sistemicorp/a5800-BONDPogo/a5800-CAD_3DwBOND_01.step

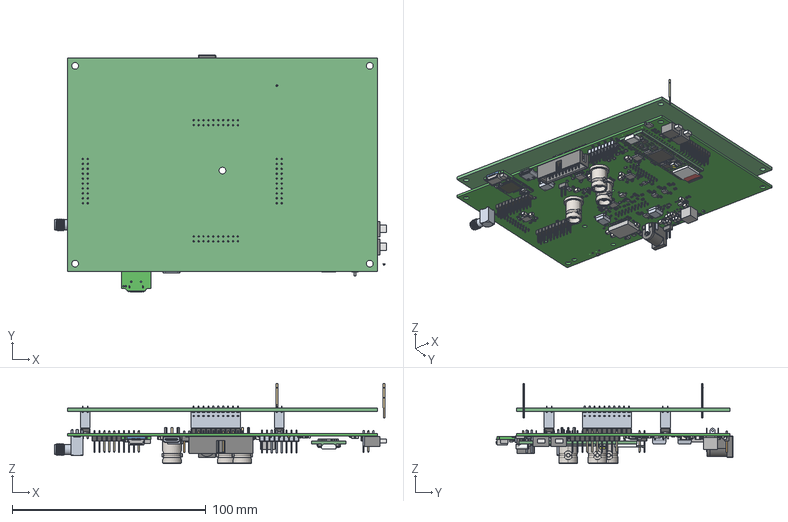
[picture p1: CAD file, 2026-10-26]
a5800-CAD_3DwBOND_01.step
171.2 x 122.2 x 41.4 mm
Extruded x 850
G3VM_61ER x 3
Board
LED0402_greenH05
R0402 x 12
C0402 x 22
C0603 x 8
Open_CASCADE_STEP_translator_6.8_1.31.1.1
Open_CASCADE_STEP_translator_6.8_1.31.1.2
SOT23-5L x 2
LED0402_redH05
R0603
Amphenol_RF_122404 x 3
733910083[1]
TP11CGRA_(1) x 2
pin_header_awl254-dg-g20d x 7
User_Library-SOT23-5-2 x 2
Teensy_4.1_Assembly_simplified
DS-261A_v1
housing x 4
cover x 4
base x 8
Polarity_Mark x 4
Würth_Elektronik_150060YS75000
20_Pin x 21
