sistemicorp/a5800-BONDPogo/a5800-SCH_01.pdf

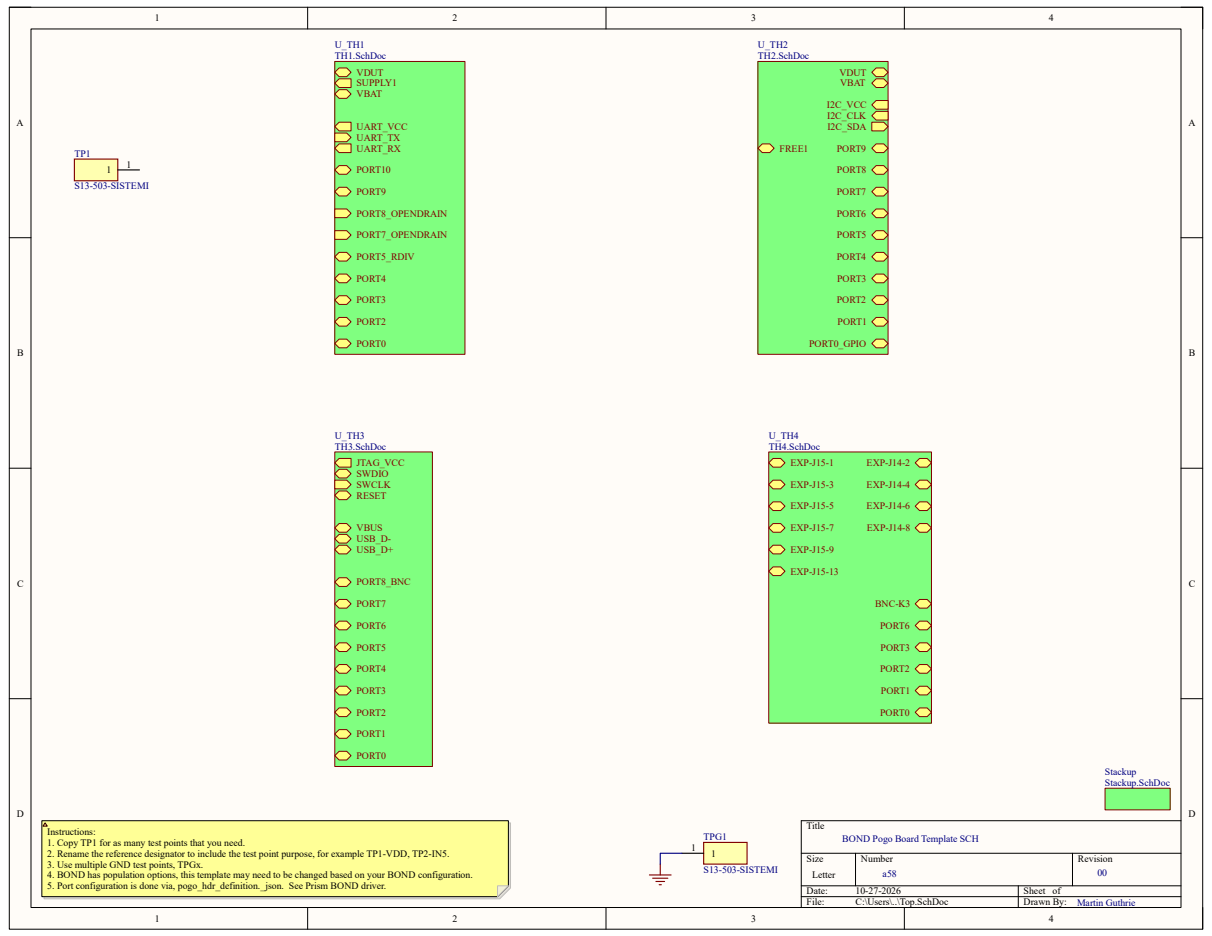
[picture p2: page 1]
Title; Size; Number; Revision; Letter; Date:; Sheet of; File:; C:\Users\..\Top.SchDoc; Drawn By:; Martin Guthrie; UART_VCC; VDUT SUPPLY1 VBAT; UART_TX UART_RX; PORT10; PORT9; PORT8_OPENDRAIN; PORT7_OPENDRAIN; PORT5_RDIV; PORT4; PORT3; PORT2; PORT0; U_TH1 TH1.SchDoc; VDUT VBAT; I2C_CLK; I2C_VCC; I2C_SDA; PORT8; PORT7; PORT6; PORT5; PORT1; PORT0_GPIO; FREE1; U_TH2 TH2.SchDoc; RESET; PORT8_BNC; JTAG_VCC SWDIO SWCLK; USB_D+; USB_D-; VBUS; U_TH3 TH3.SchDoc; EXP-J14-2; EXP-J14-4; EXP-J14-6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

Instructions:
1. Copy TP1 for as many test points that you need.
2. Rename the reference designator to include the test point purpose, for example TP1-VDD, TP2-IN5.
3. Use multiple GND test points, TPGx.
4. BOND has population options, this template may need to be changed based on your BOND configuration.
5. Port configuration is done via, pogo_hdr_definition._json. See Prism BOND driver.

BOND Pogo Board Template SCH

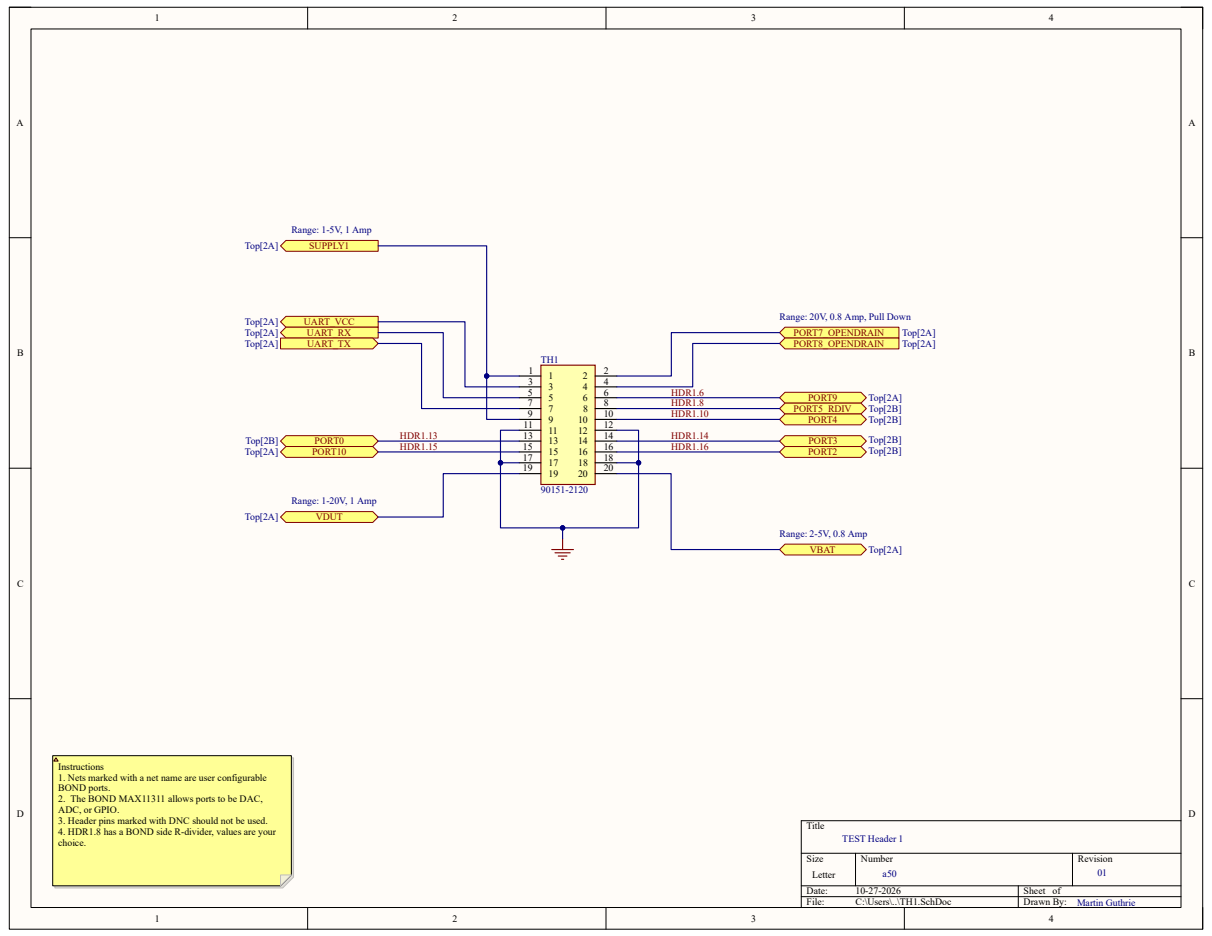
[picture p3: page 2]
Title; File:; C:\Users\..\TH1.SchDoc; Drawn By:; Top[2A]; SUPPLY1; UART_VCC; UART_RX; UART_TX; Top[2B]; PORT0; VDUT; PORT7_OPENDRAIN; PORT8_OPENDRAIN; PORT9; PORT5_RDIV; PORT4; PORT3; PORT2; VBAT; TEST Header 1; HDR1.8; HDR1.6; HDR1.10; HDR1.13; HDR1.14; HDR1.16 Top[2A]; PORT10; HDR1.15; Range: 1-5V, 1 Amp; Range: 1-20V, 1 Amp; Range: 2-5V, 0.8 Amp

Range: 20V, 0.8 Amp, Pull Down

Instructions
1. Nets marked with a net name are user configurable
BOND ports.
2. The BOND MAX11311 allows ports to be DAC,
ADC, or GPIO.
3. Header pins marked with DNC should not be used.
4. HDR1.8 has a BOND side R-divider, values are your
choice.

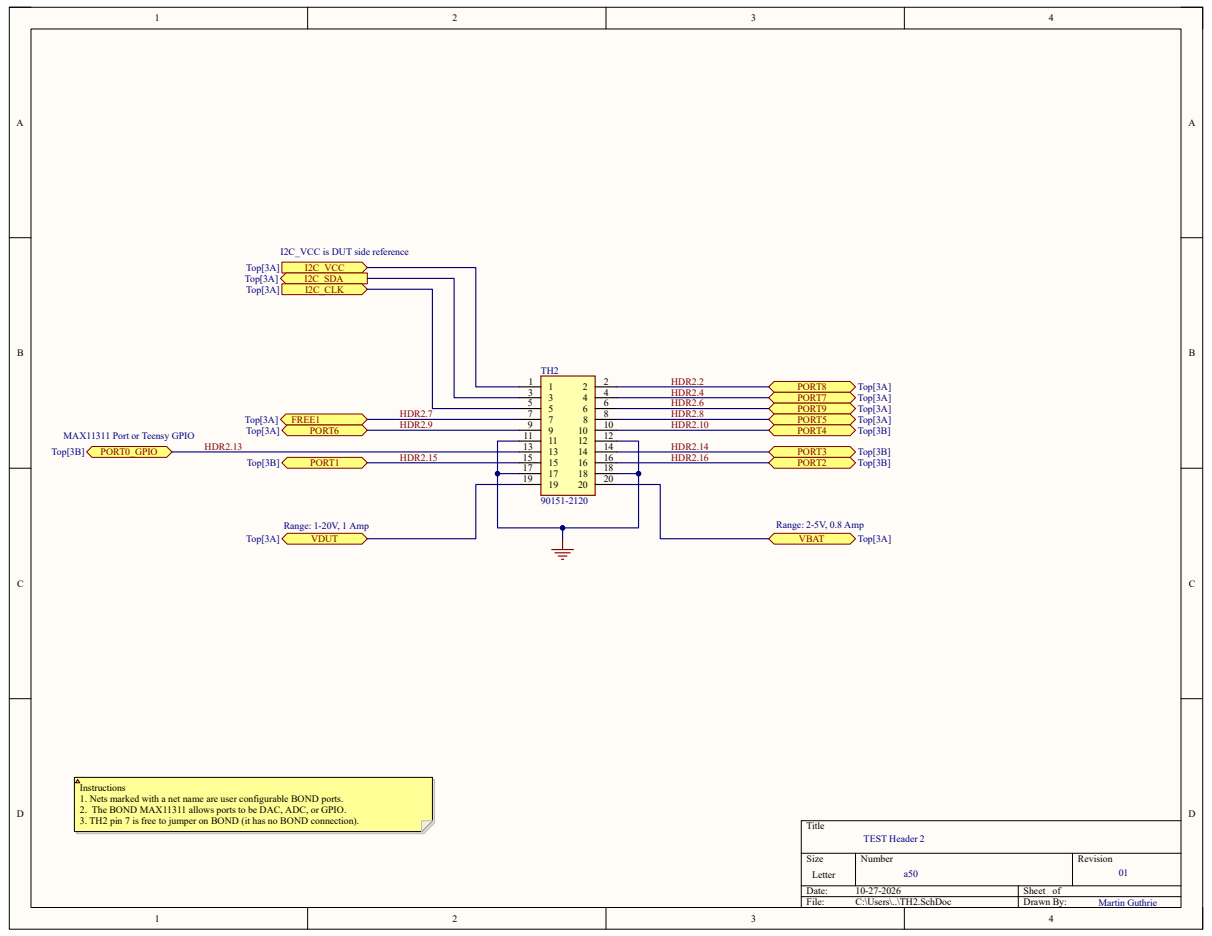
[picture p4: page 3]
Title; File:; C:\Users\..\TH2.SchDoc; Drawn By:; Top[3A]; I2C_VCC; I2C_SDA; I2C_CLK; PORT6; Top[3B]; PORT0_GPIO; PORT1; VDUT; PORT8; PORT7; PORT9; PORT5; PORT4; PORT3; PORT2; VBAT; TEST Header 2; Range: 1-20V, 1 Amp; Range: 2-5V, 0.8 Amp; HDR2.2 HDR2.4 HDR2.6 HDR2.8 HDR2.10; HDR2.14; HDR2.15; HDR2.16; HDR2.13; HDR2.9; Top[3A] FREE1; HDR2.7

I2C_VCC is DUT side reference

MAX11311 Port or Teensy GPIO

Instructions
1. Nets marked with a net name are user configurable BOND ports.
2. The BOND MAX11311 allows ports to be DAC, ADC, or GPIO.
3. TH2 pin 7 is free to jumper on BOND (it has no BOND connection).

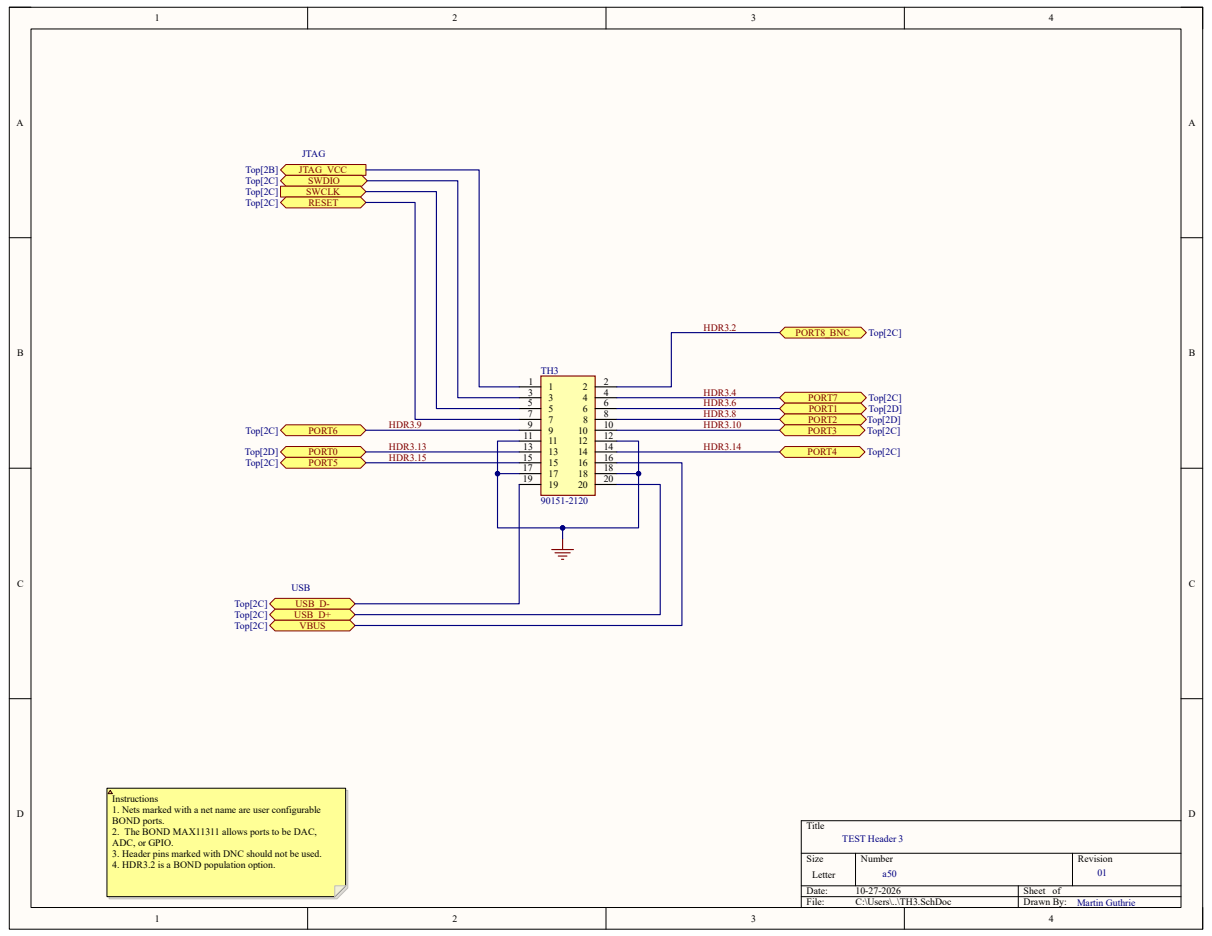
[picture p5: page 4]
Title; File:; C:\Users\..\TH3.SchDoc; Drawn By:; Top[2B]; JTAG_VCC; Top[2C]; SWDIO; SWCLK; RESET; Top[2D]; PORT0; PORT5; USB_D-; PORT8_BNC; PORT7; PORT1; PORT2; PORT3; PORT4; VBUS; USB_D+; TEST Header 3; PORT6; HDR3.4 HDR3.6 HDR3.8 HDR3.10; HDR3.14; HDR3.9; HDR3.13 HDR3.15; JTAG; HDR3.2; USB

Instructions
1. Nets marked with a net name are user configurable
BOND ports.
2. The BOND MAX11311 allows ports to be DAC,
ADC, or GPIO.
3. Header pins marked with DNC should not be used.
4. HDR3.2 is a BOND population option.

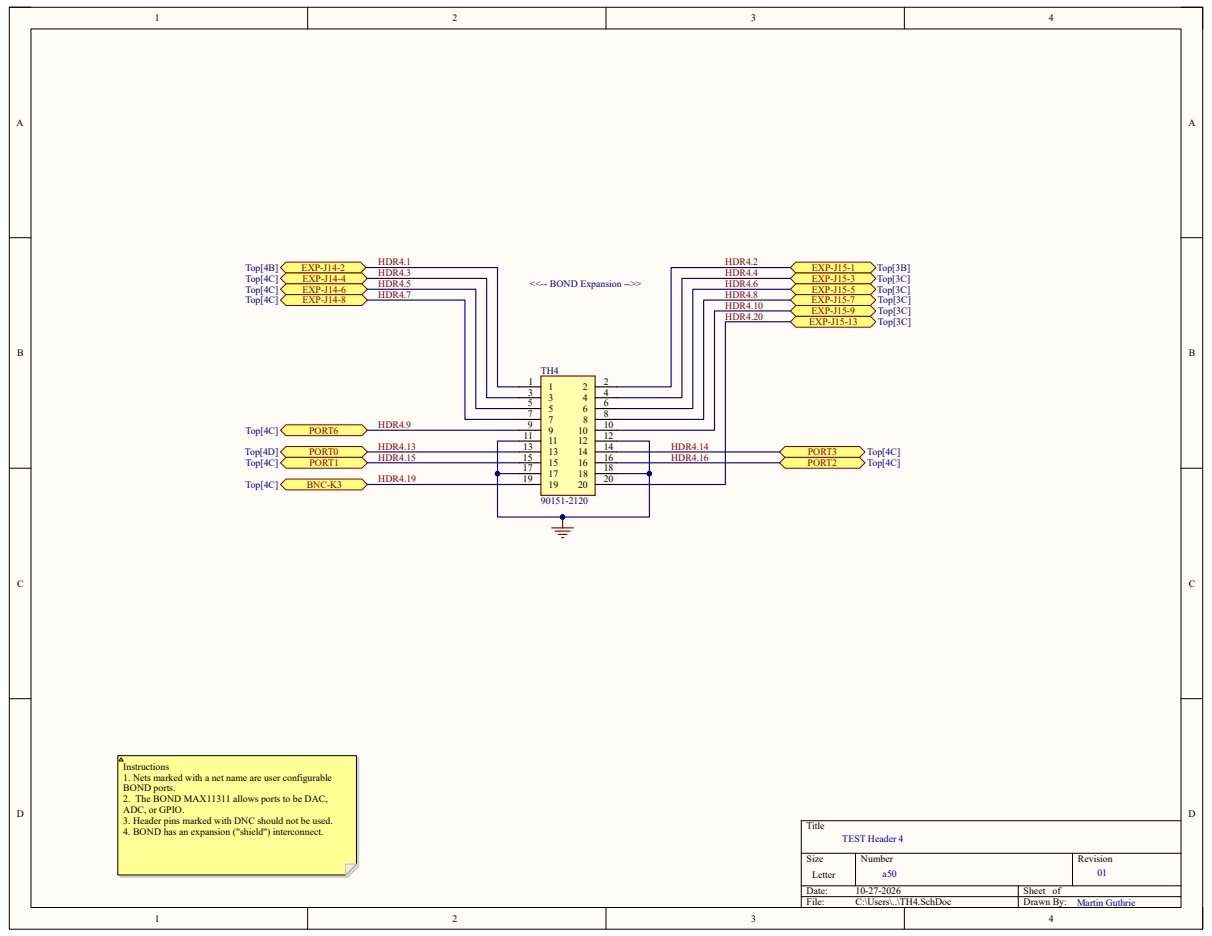
[picture p6: page 5]
Title; File:; C:\Users\..\TH4.SchDoc; Drawn By:; Top[4B]; EXP-J14-2; Top[4C]; EXP-J14-4; EXP-J14-6; EXP-J14-8; Top[4D]; PORT0; PORT1; BNC-K3; EXP-J15-1; Top[3B]; EXP-J15-3; Top[3C]; EXP-J15-5; EXP-J15-7; EXP-J15-9; PORT3; PORT2; EXP-J15-13; TEST Header 4; PORT6; HDR4.1 HDR4.3 HDR4.5 HDR4.7; HDR4.9; HDR4.13 HDR4.15; HDR4.19; HDR4.2 HDR4.4 HDR4.6 HDR4.8 HDR4.10 HDR4.20; HDR4.14 HDR4.16; <<-- BOND Expansion -->>

Instructions
1. Nets marked with a net name are user configurable
BOND ports.
2. The BOND MAX11311 allows ports to be DAC,
ADC, or GPIO.
3. Header pins marked with DNC should not be used.
4. BOND has an expansion ("shield") interconnect.

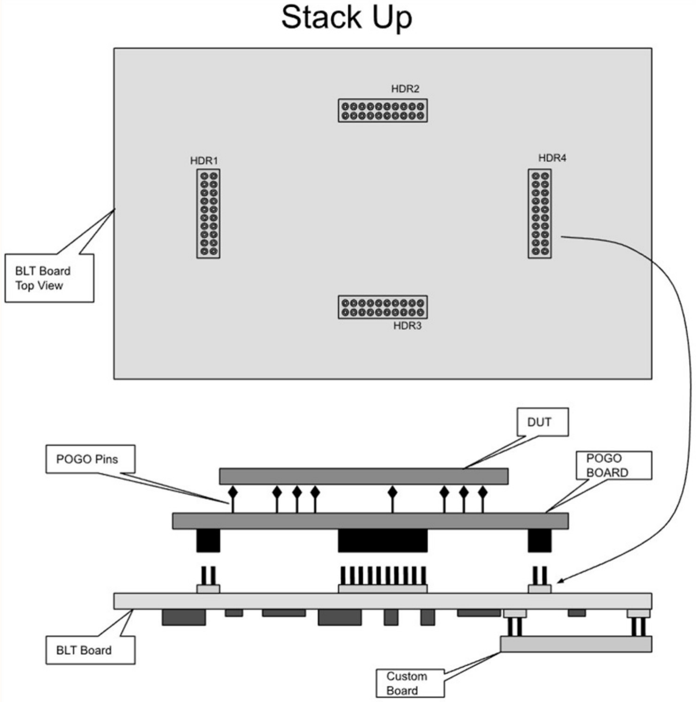
[picture p7: figure]

D D

C C

B B

A A

Title

File: | C:\Users\..\Stackup.SchDoc | Drawn By:
| Stackup Illustration and Notes
a58 | 01

NOTES:

1) The diagram shows the overall stackup of the BLT Board (BOND), the Pogo Board (this Schematic) and the Device Under Test (DUT).
2) The BOND (BLT) board components face away from the Pogo Board. The Headers on BOND face the Pogo Board.
