sistemicorp/a5800-BONDPogo/a4402-SCH_03.pdf

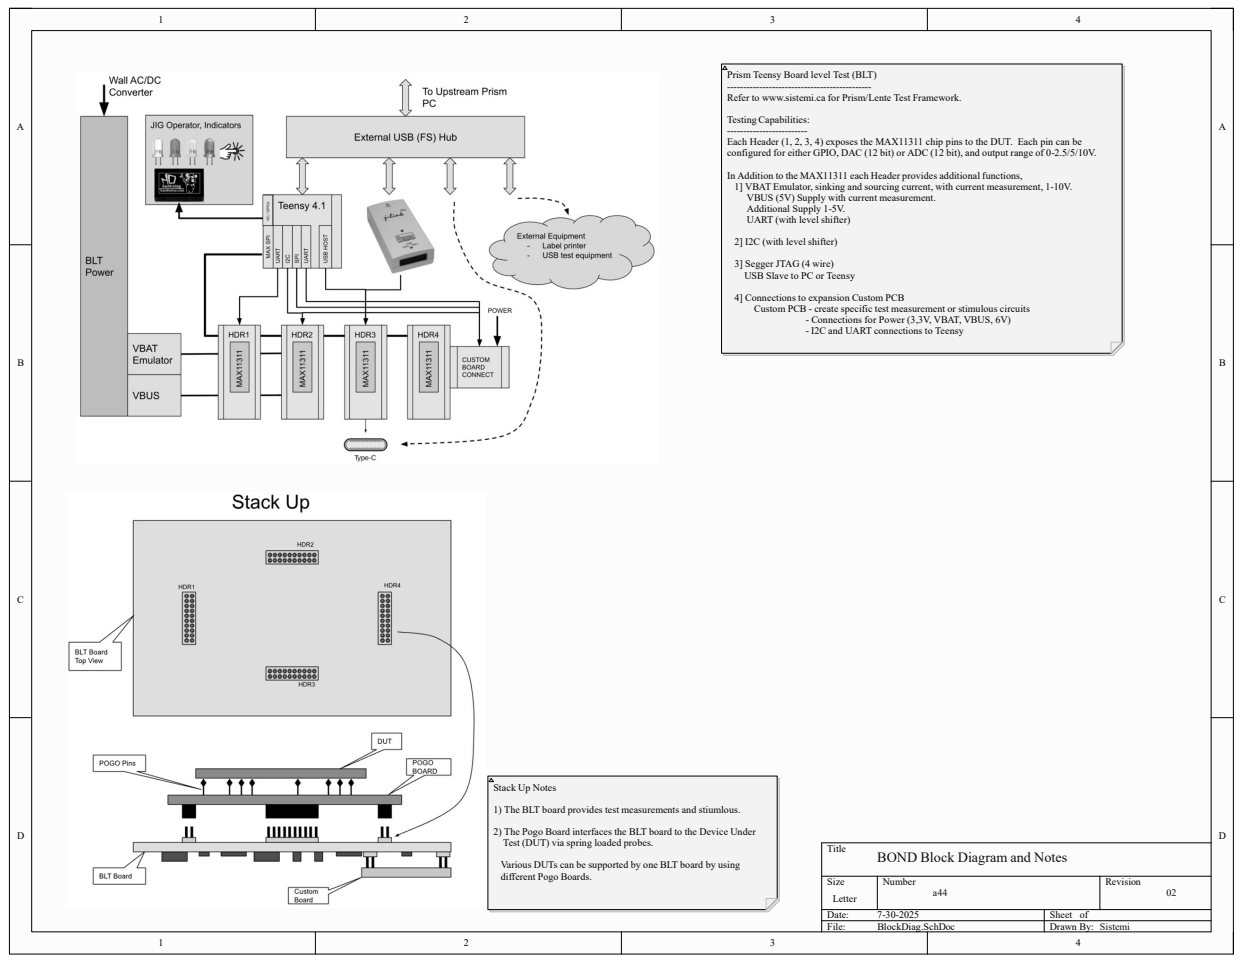
[picture p8: page 1]
Title; Size; Number; Revision; Letter; Date:; Sheet of; File:; BlockDiag.SchDoc; Drawn By: Sistemi

Prism Teensy Board level Test (BLT)
Refer to www.sistemi.ca for Prism/Lente Test Framework.

Testing Capabilities:
Each Header (1, 2, 3, 4) exposes the MAX11311 chip pins to the DUT. Each pin can be
configured for either GPIO, DAC (12 bit) or ADC (12 bit), and output range of 0-2.5/5/10V.

In Addition to the MAX11311 each Header provides additional functions,
1] VBAT Emulator, sinking and sourcing current, with current measurement, 1-10V.
VBUS (5V) Supply with current measurement.
Additional Supply 1-5V.
UART (with level shifter)

2] I2C (with level shifter)

3] Segger JTAG (4 wire)
USB Slave to PC or Teensy

4] Connections to expansion Custom PCB
Custom PCB - create specific test measurement or stimulous circuits

- Connections for Power (3,3V, VBAT, VBUS, 6V)
- I2C and UART connections to Teensy

Stack Up Notes

1) The BLT board provides test measurements and stiumlous.

2) The Pogo Board interfaces the BLT board to the Device Under
Test (DUT) via spring loaded probes.

Various DUTs can be supported by one BLT board by using
different Pogo Boards.

BOND Block Diagram and Notes

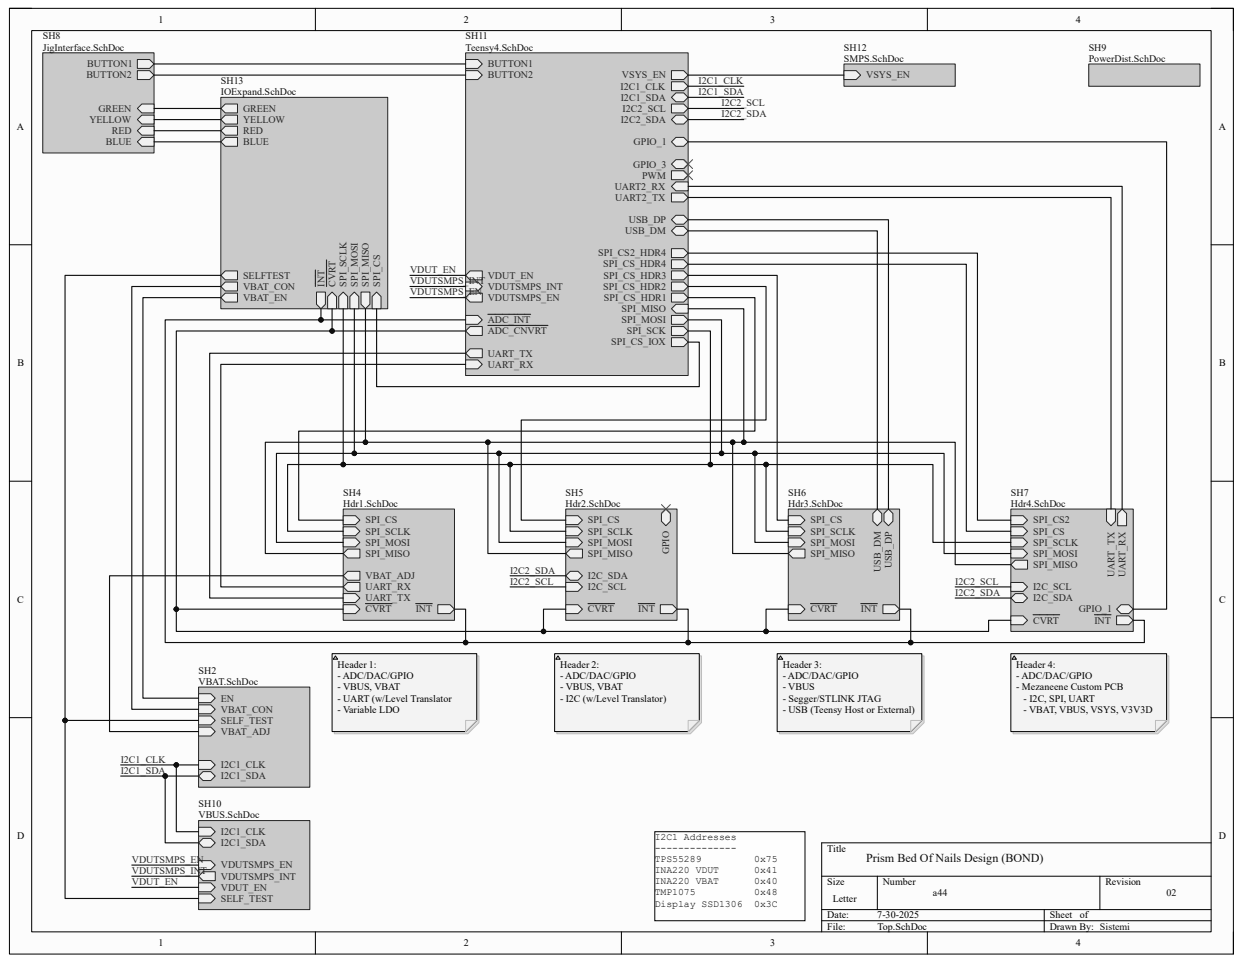
[picture p9: page 2]
File:; Top.SchDoc; Drawn By:; Sistemi; I2C1_SDA; EN VBAT_CON SELF_TEST; I2C1_CLK; VBAT_ADJ; SH2 VBAT.SchDoc; SPI_MOSI; SPI_CS; INT; SPI_MISO; SPI_SCLK; CVRT; UART_TX; UART_RX; SH4 Hdr1.SchDoc; I2C_SDA I2C_SCL; INT GPIO; SH5 Hdr2.SchDoc; INT USB_DM USB_DP; SH6 Hdr3.SchDoc; SPI_CS2; I2C_SDA; SPI_SCLK SPI_MOSI; I2C_SCL; GPIO_1 UART_TX UART_RX; SH7 Hdr4.SchDoc; BLUE; YELLOW RED; BUTTON1; GREEN; BUTTON2; JigInterface.SchDoc; PowerDist.SchDoc; VDUTSMPS_EN VDUTSMPS_INT; SELF_TEST; VDUT_EN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

Header 1:
- ADC/DAC/GPIO
- VBUS, VBAT
- UART (w/Level Translator
- Variable LDO

Header 2:
- I2C (w/Level Translator)

Header 3:
- VBUS
- Segger/STLINK JTAG
- USB (Teensy Host or External)

Header 4:
- Mezaneene Custom PCB
- I2C, SPI, UART
- VBAT, VBUS, VSYS, V3V3D

Title
Prism Bed Of Nails Design (BOND)

## Teensy Powered by VBUS

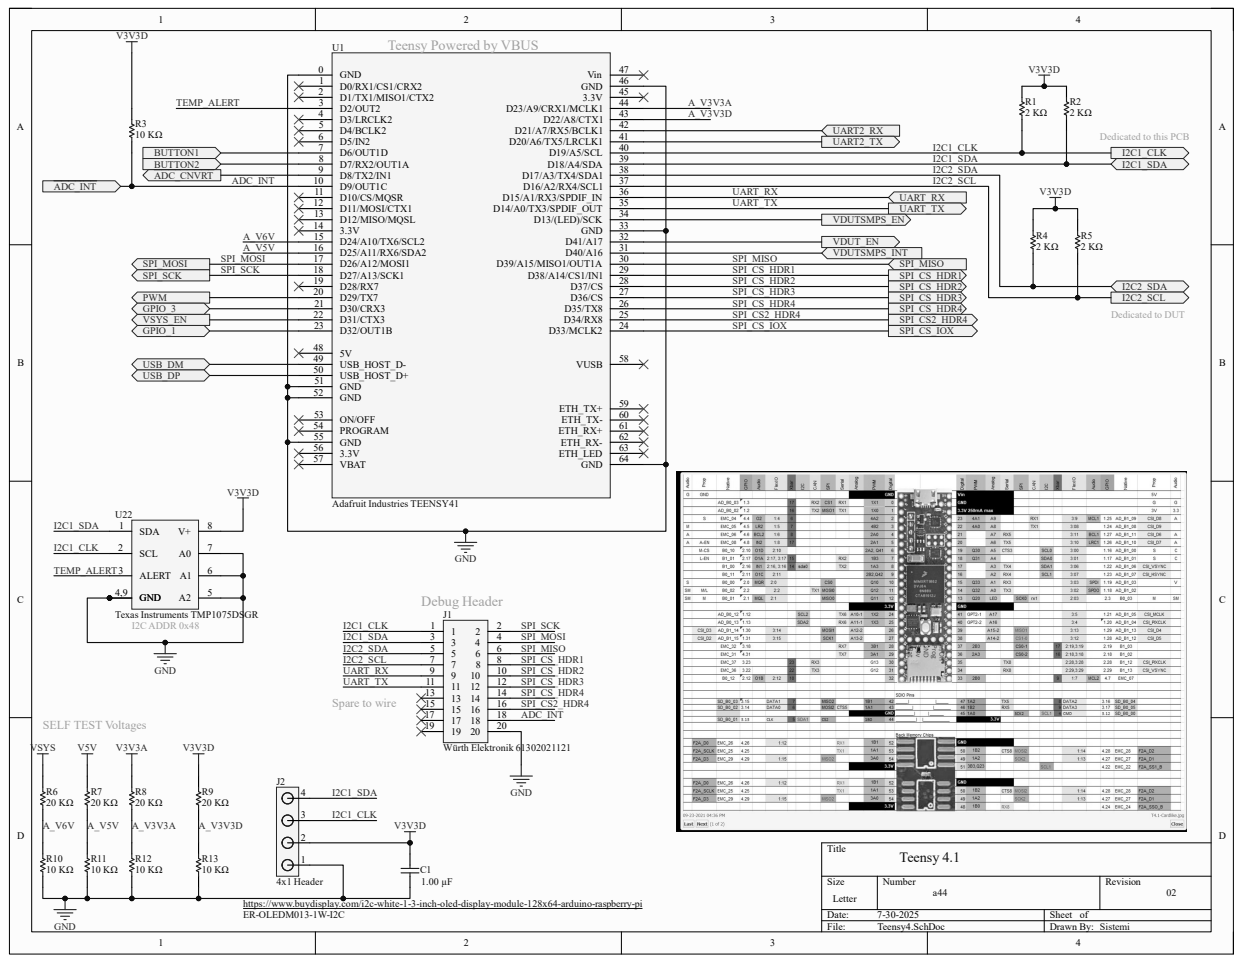
[picture p10: page 3]

Dedicated to this PCB

https://www.buydisplay.com/i2c-white-1-3-inch-oled-display-module-128x64-arduino-raspberry-pi
ER-OLEDM013-1W-I2C

# D1 Würth Elektronik 150060GS⁷⁵⁰⁰⁰

## Reference For ADC Calibration

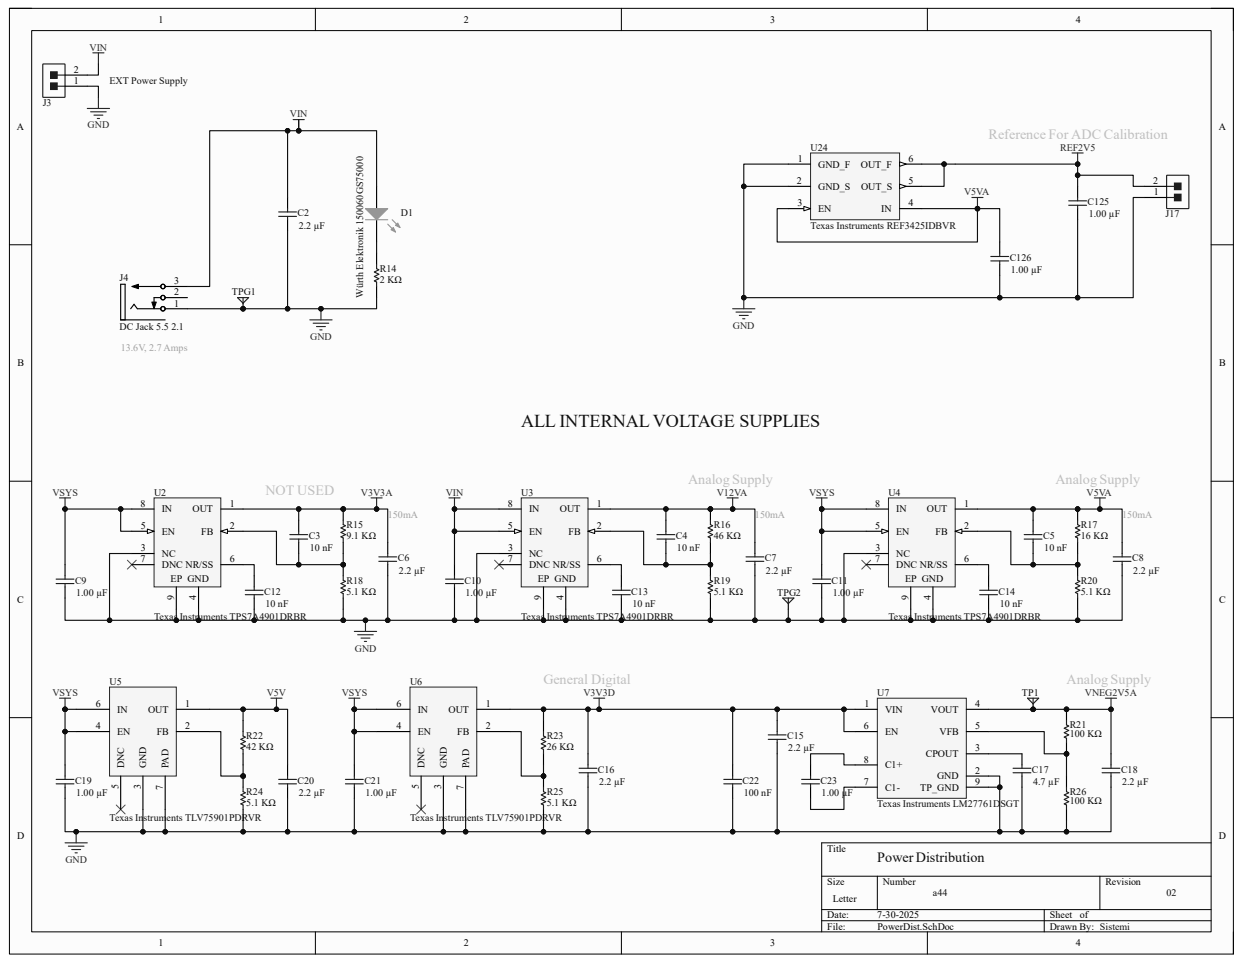
[picture p11: page 4]

ALL INTERNAL VOLTAGE SUPPLIES

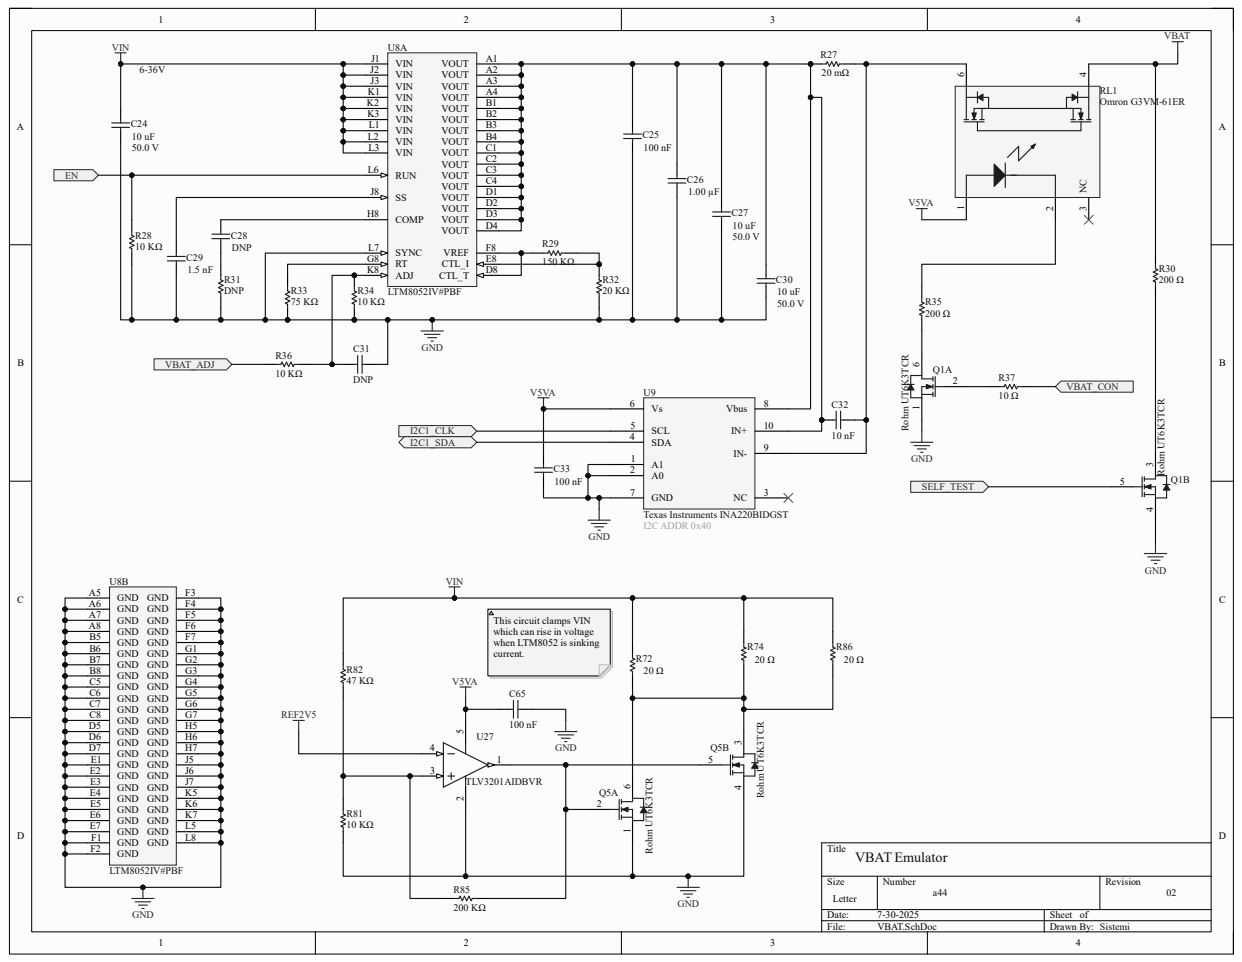
[picture p12: page 5]

This circuit clamps VIN
which can rise in voltage
when LTM8052 is sinking
current.

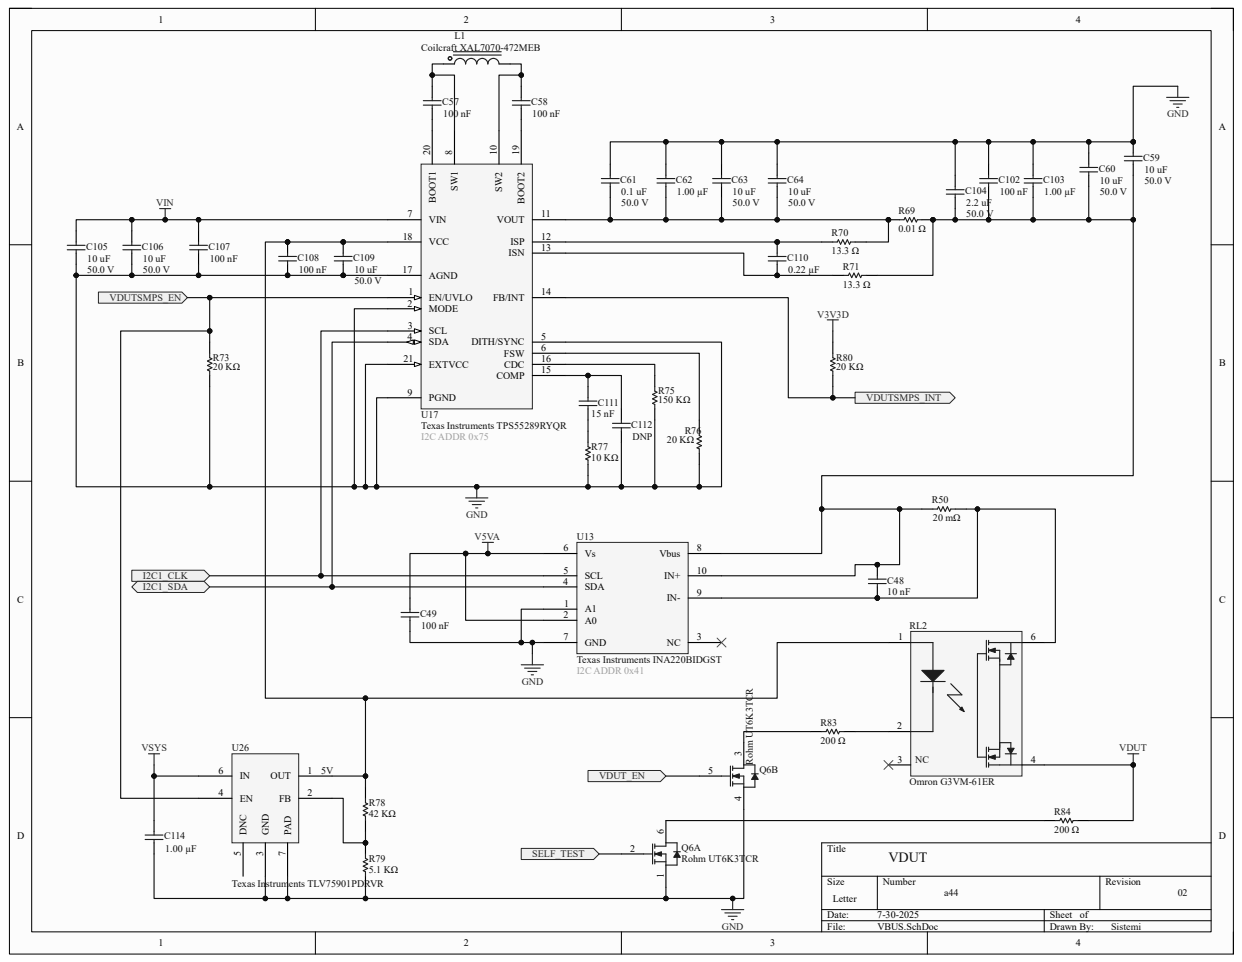
[picture p13: page 6]

## Mounted LEDs/Switches Cable Harness LED Status on-board and off-board, in

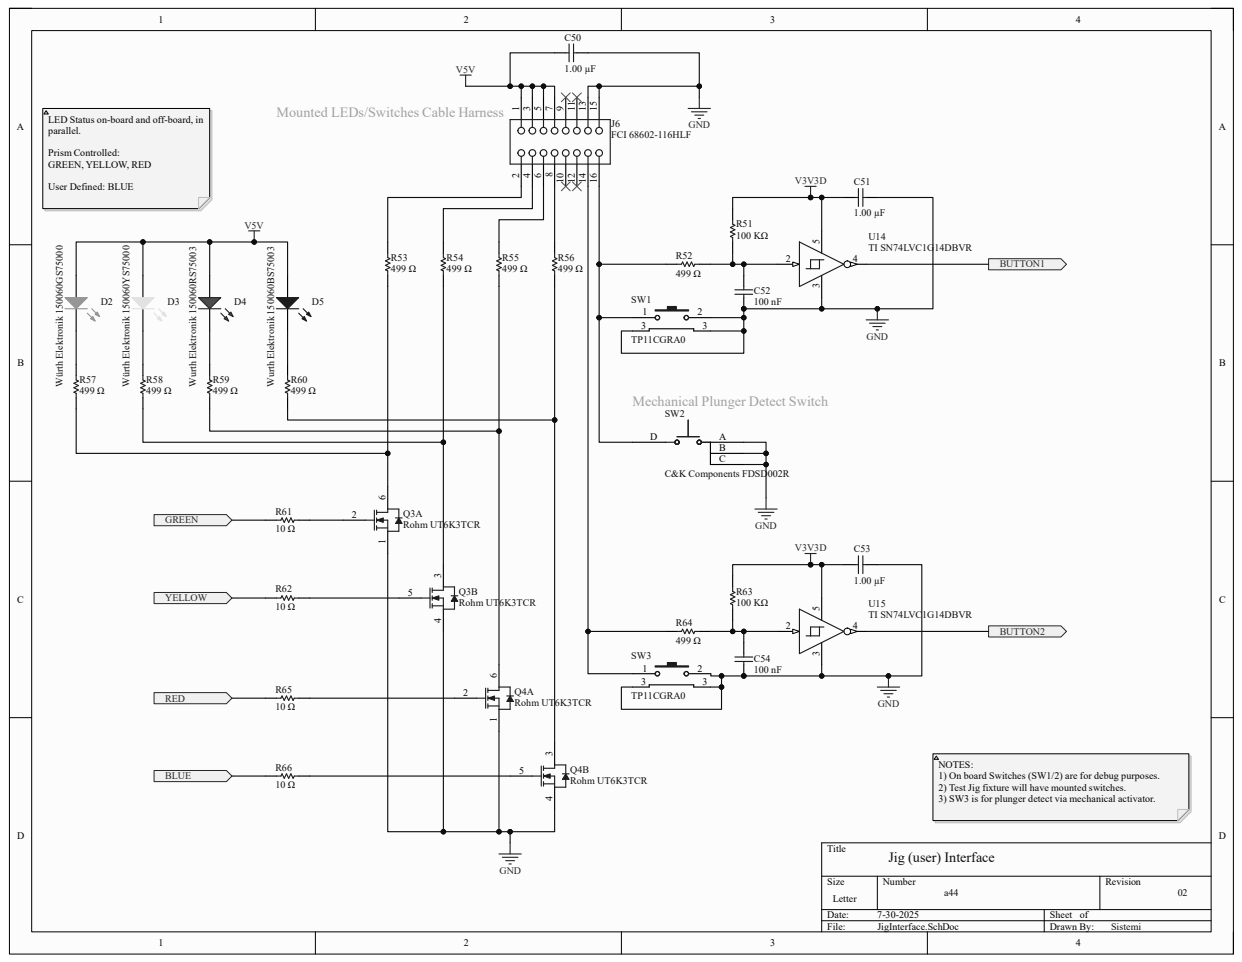
[picture p14: page 7]

Mechanical Plunger Detect Switch

NOTES:
1) On board Switches (SW1/2) are for debug purposes.
2) Test Jig fixture will have mounted switches.
3) SW3 is for plunger detect via mechanical activator.

## DUT Hdr

# GNDUART

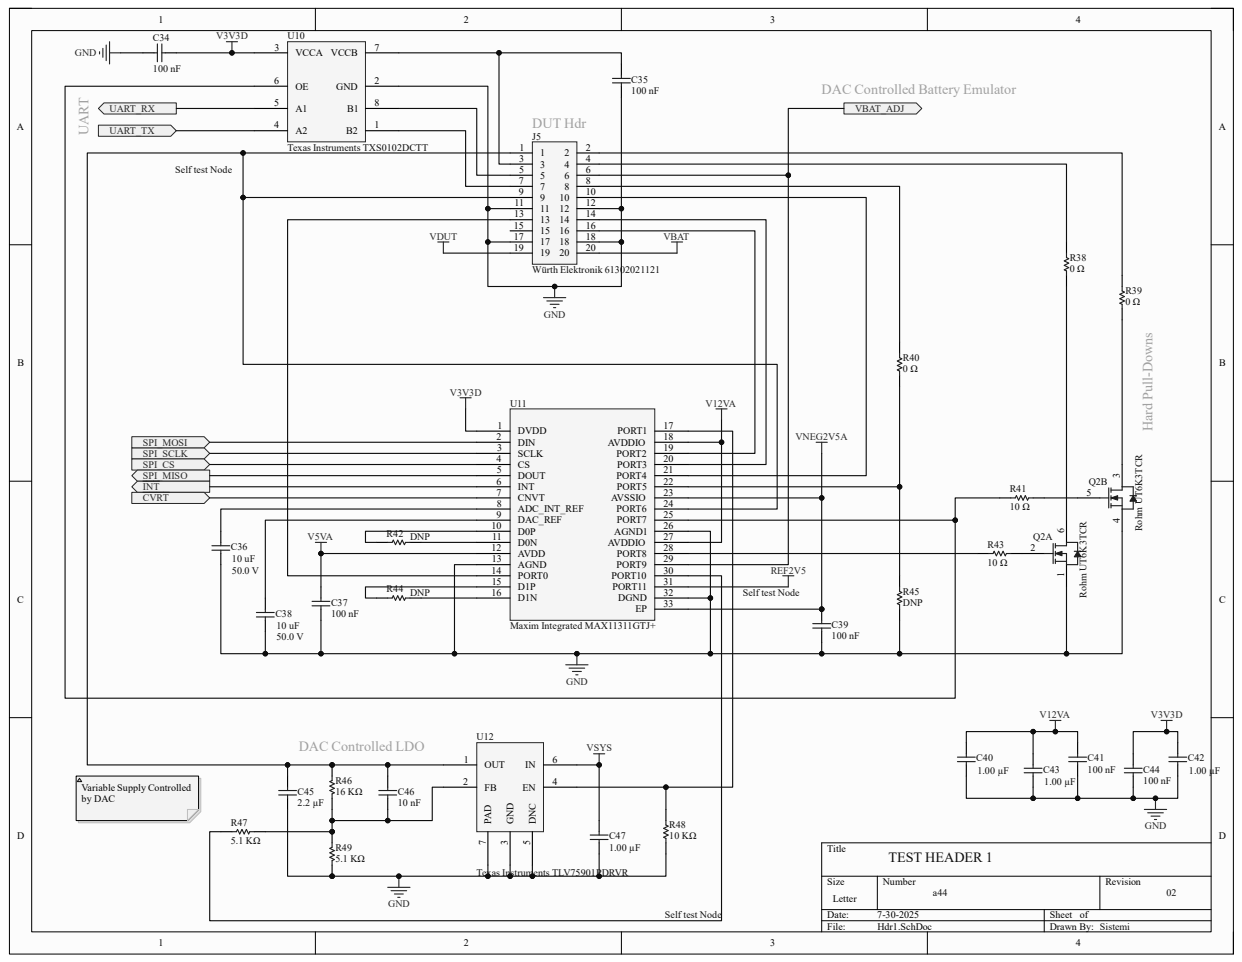
[picture p15: page 8]

DAC Controlled Battery Emulator

## DUT Hdr

## Teensy to DUT I2C

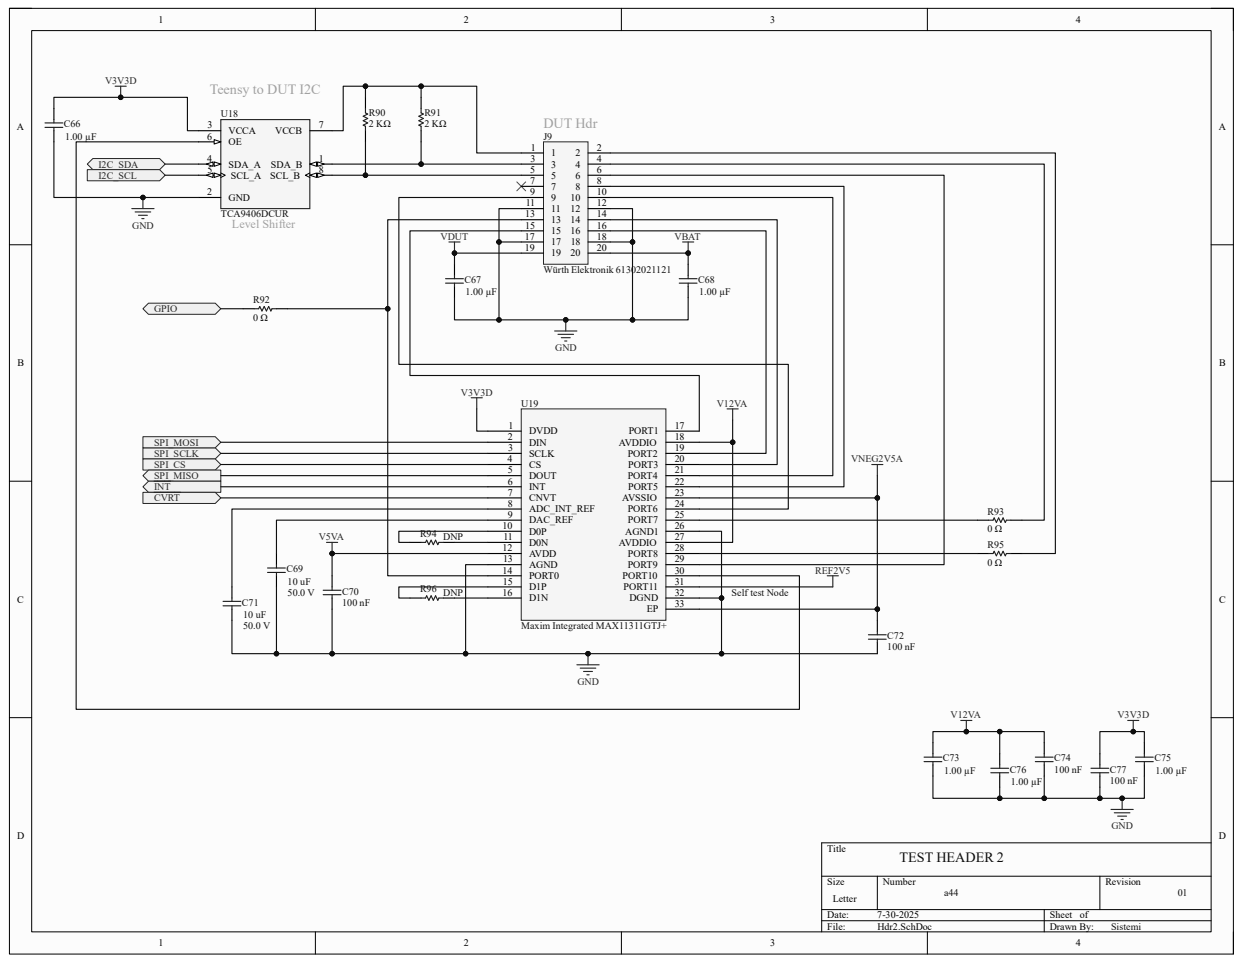
[picture p16: page 9]

## DUT Hdr

## Teensy Host Controller

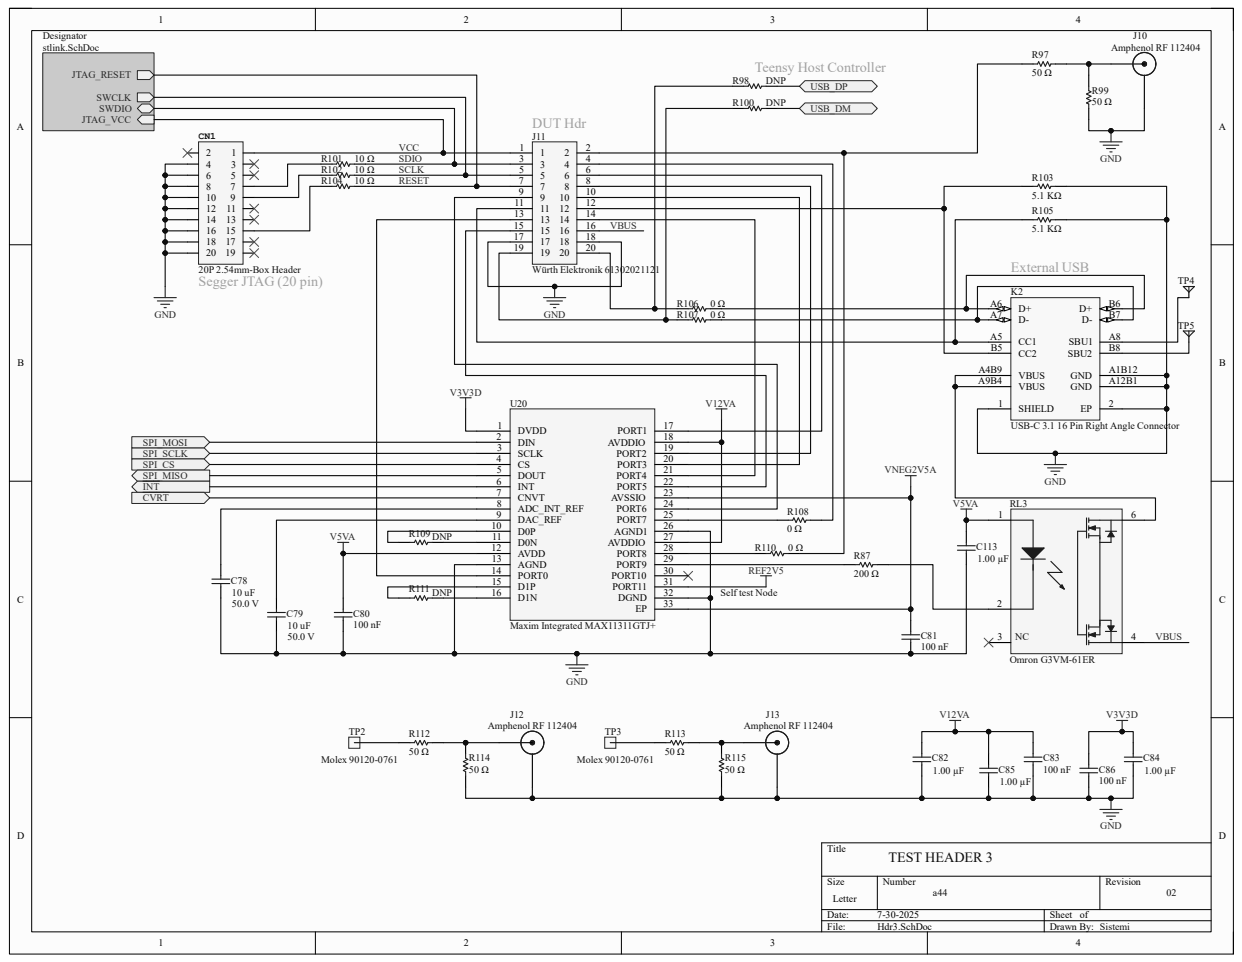
[picture p17: page 10]

USB-C 3.1 16 Pin Right Angle Connector

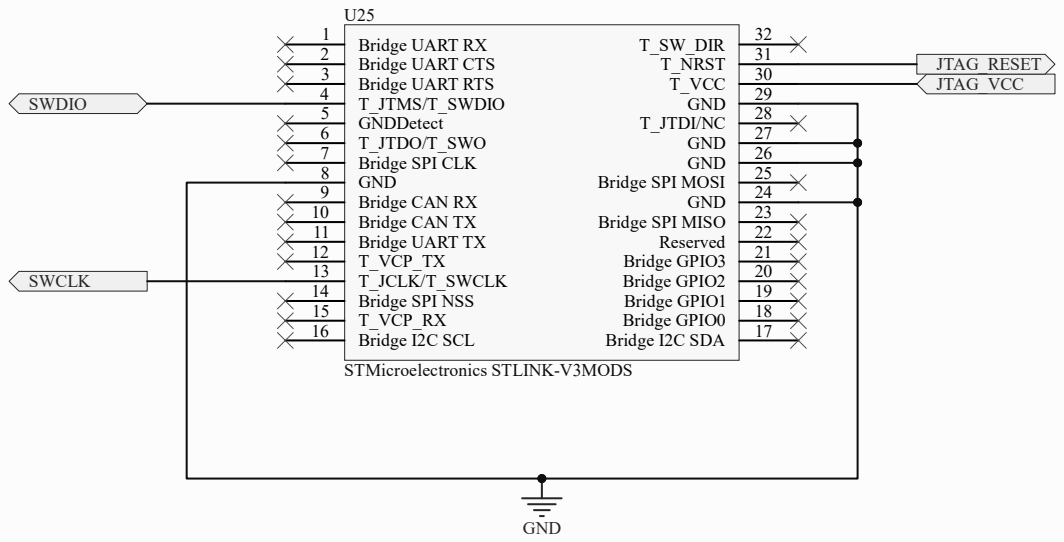
[picture p18: page 11]
Title; File:; stlink.SchDoc; Drawn By:; Bridge I2C SCL 16; Bridge I2C SDA; 17 Bridge GPIO0; 18 Bridge GPIO1; 19 Bridge GPIO2; 20 Bridge GPIO3; 21 Reserved; 22 Bridge SPI MISO; 23 GND; 24 Bridge SPI MOSI; 25 GND; 26 GND; 27 T_JTDI/NC; 28 GND; 29 T_VCC; 30 T_NRST; 31 T_SW_DIR; STMicroelectronics STLINK-V3MODS; Sistemi; STLINK-V3MODS; GND; SWDIO; JTAG_VCC; SWCLK; JTAG_RESET

Bridge UART RX 1
Bridge UART CTS 2
Bridge UART RTS 3
T_JTMS/T_SWDIO 4
GNDDetect 5
T_JTDO/T_SWO 6
Bridge SPI CLK 7
GND 8
Bridge CAN RX 9
Bridge CAN TX 10
Bridge UART TX 11
T_VCP_TX 12
T_JCLK/T_SWCLK 13
Bridge SPI NSS 14
T_VCP_RX 15

<<< | Mezenene (Daughter) Board Connectors | >>>

## DUT Hdr

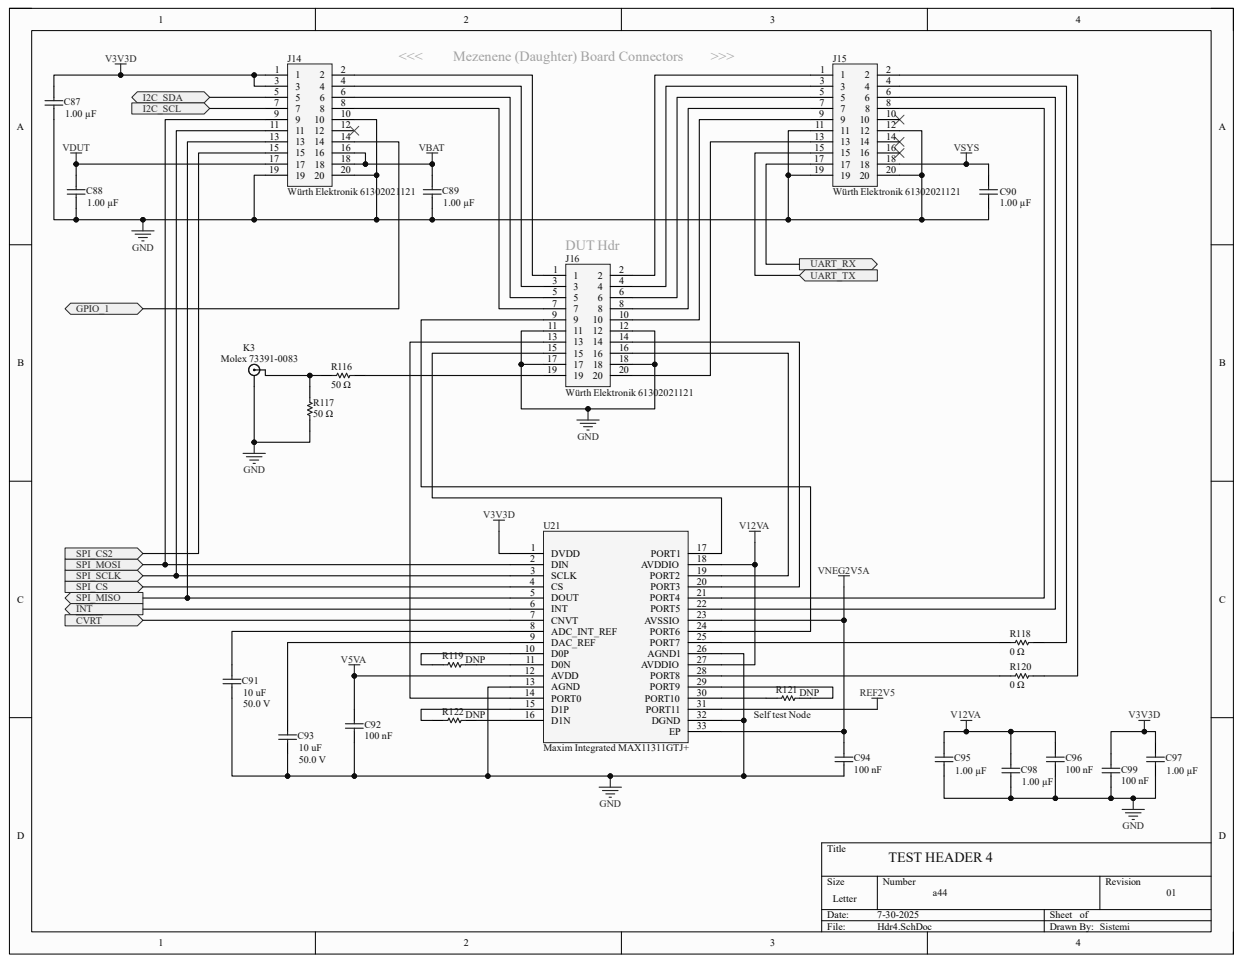
[picture p19: page 12]

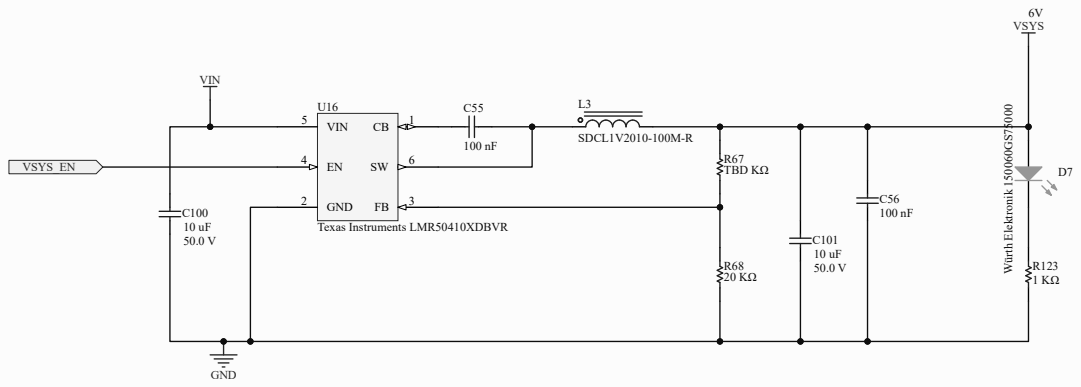
[picture p20: page 13]

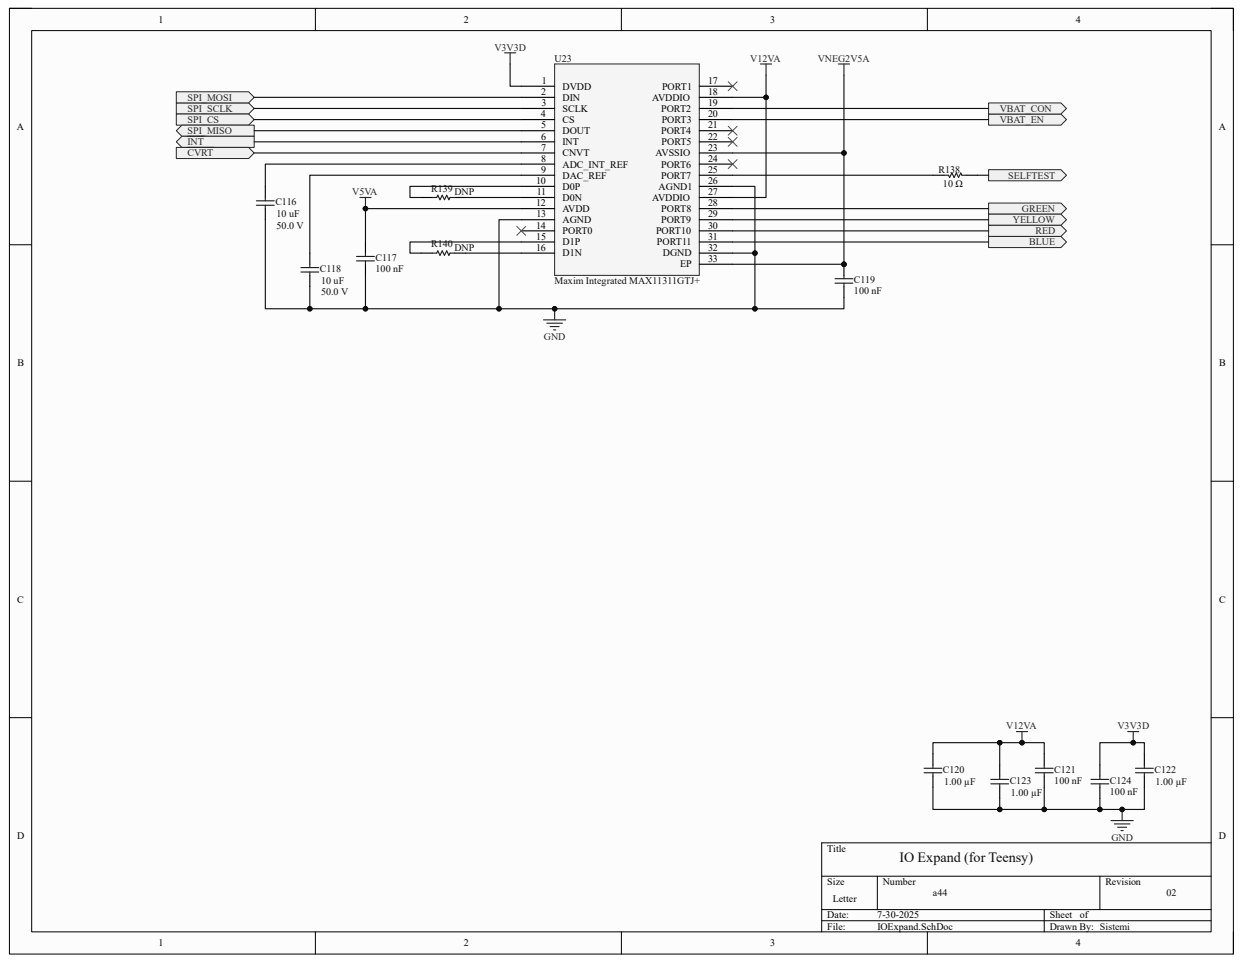
[picture p21: page 14]

IO Expand (for Teensy)
