sistemicorp/a5800-BONDPogo/(list of files, drawings)

Other design files:
a5800-BONDPogo.PrjPcb
a5800-CAD_Pcb.PcbDoc
Stackup.SchDoc
TH1.SchDoc
TH2.SchDoc
TH3.SchDoc
TH4.SchDoc
Top.SchDoc
