sistemicorp/a5800-BONDPogo/(commit log)

2025-08-19 Directory copy from 'https://afs-vcs-ue1.365.altium.com/EF3C7497-8D4B-4B23-8D4A-C7B75E6A84FB' by MARTIN GUTHRIE
    [PCB2.PcbDoc, Stackup.SchDoc, TH1.SchDoc, TH2.SchDoc, TH3.SchDoc, TH4.SchDoc, Top.SchDoc, a5800-BONDPogo.PrjPcb]
2025-08-19 wip template
    [Top.SchDoc]
2025-08-28 Initial fixes
    [Pcb.PcbDoc, TH1.SchDoc, TH2.SchDoc, TH3.SchDoc, TH4.SchDoc, Top.SchDoc, a5001-CAD_FullStack_02.PcbDoc, a5800-BONDPogo.PrjPcb]
2025-08-28 New BOND a4402 STEP placed in Layout
    [Pcb.PcbDoc]
2025-08-28 Connected 2 PCBs together in 3D, changed thickness to 2 mm in drawings
    [Pcb.PcbDoc]
2026-10-27 README: how to start a Pogo board, BOND schematic SCH_05
2026-10-27 README: board outline can change
